SoilWaterLab/StreamGauge/Images/image029.jpg

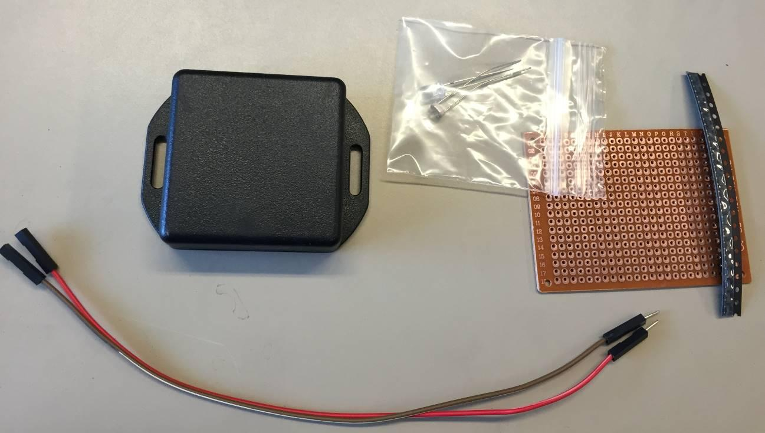
Images/image029.jpg
