SoilWaterLab/StreamGauge/Images/image031.jpg

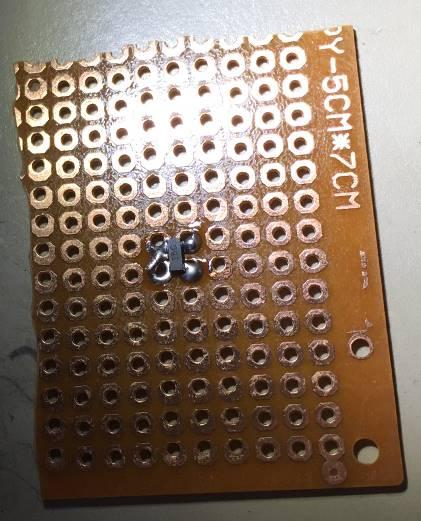
Images/image031.jpg
