SoilWaterLab/StreamGauge/Images/image033.jpg

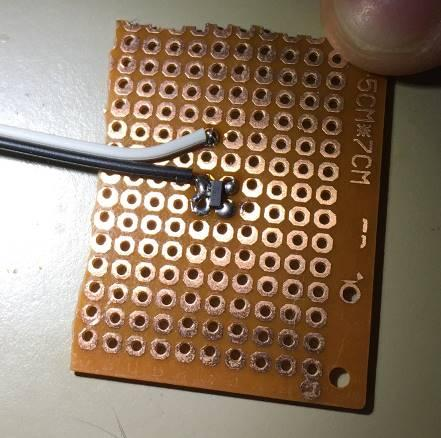
Images/image033.jpg
