SoilWaterLab/StreamGauge/Images/image035.jpg

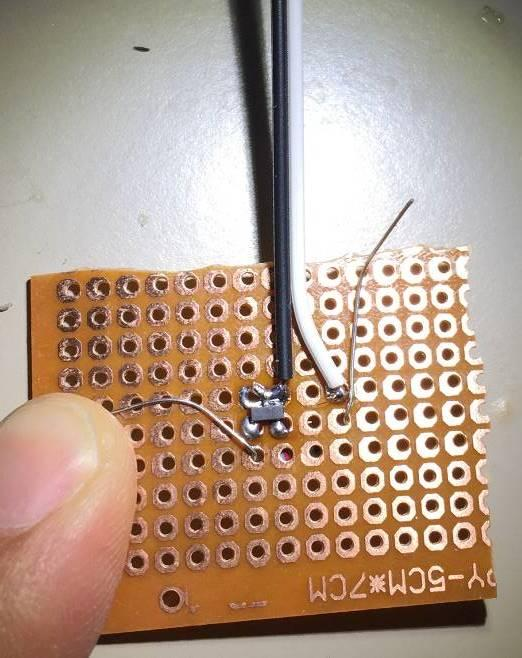
Images/image035.jpg
