SoilWaterLab/StreamGauge/Images/image037.jpg

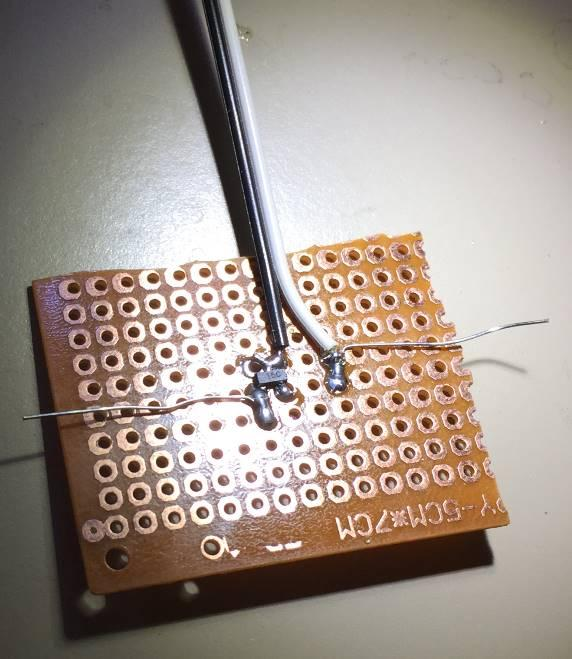
Images/image037.jpg
