SoilWaterLab/StreamGauge/Images/image039.jpg

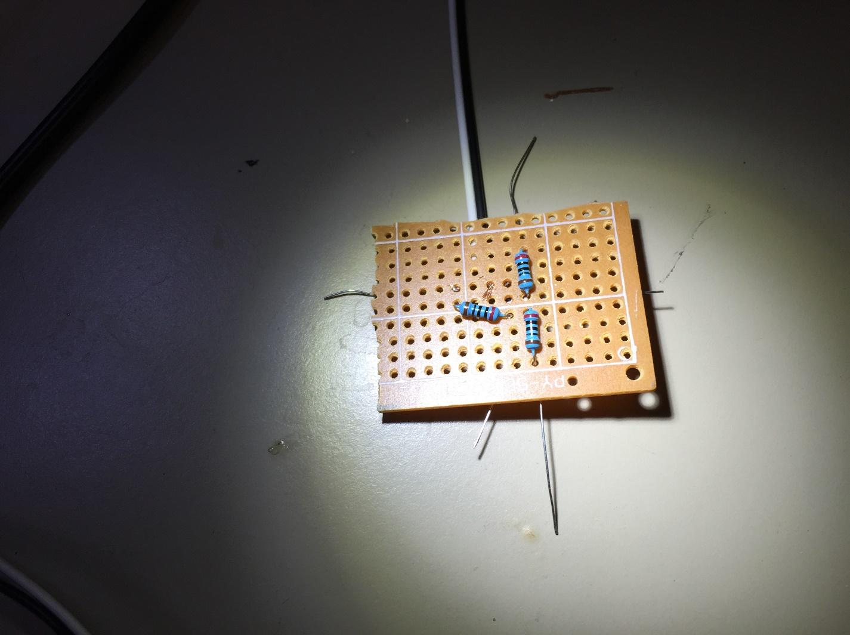
Images/image039.jpg
