SoilWaterLab/StreamGauge/Images/image041.jpg

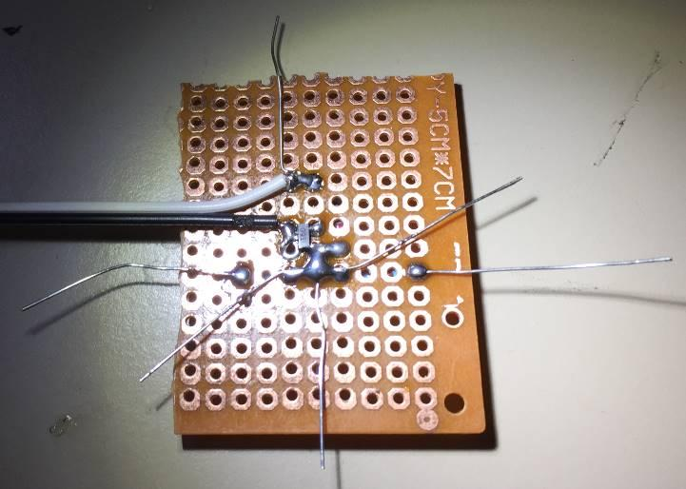
Images/image041.jpg
