SoilWaterLab/StreamGauge/Images/image043.jpg

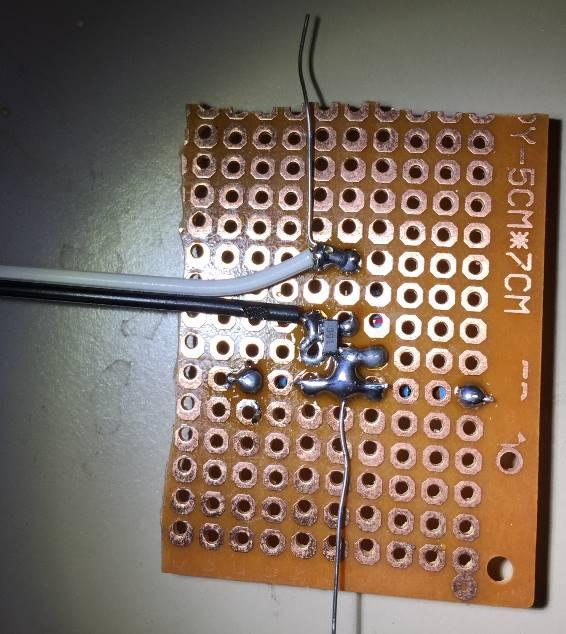
Images/image043.jpg
