SoilWaterLab/StreamGauge/Images/image045.jpg

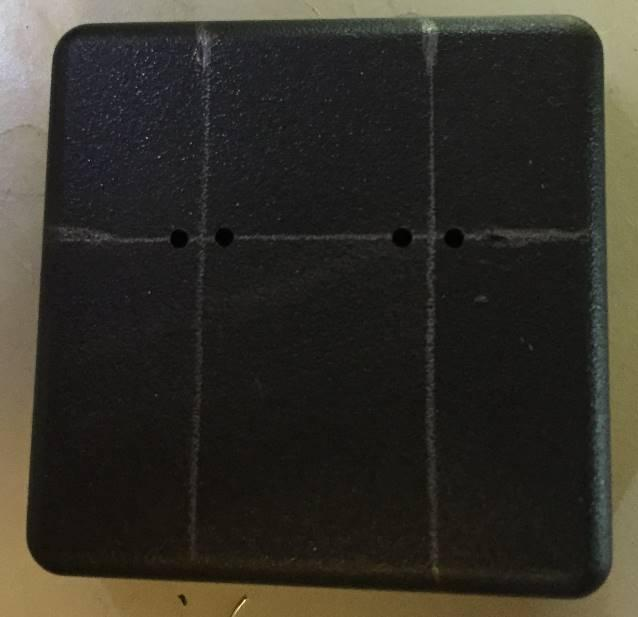
Images/image045.jpg
