SoilWaterLab/StreamGauge/Images/image047.jpg

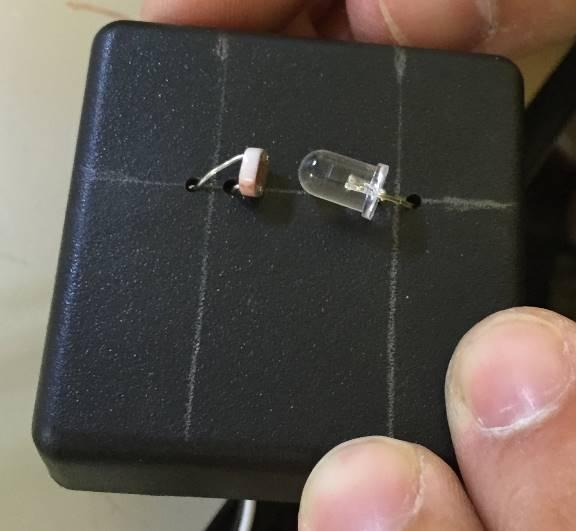
Images/image047.jpg
