SoilWaterLab/StreamGauge/Images/image049.jpg

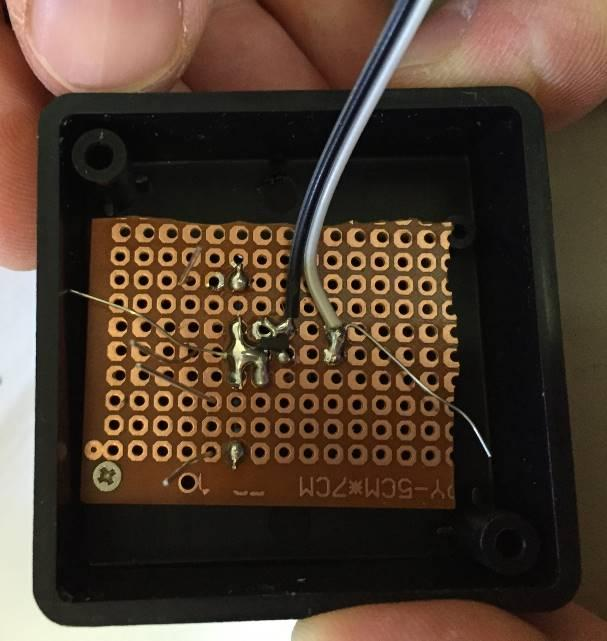
Images/image049.jpg
