SoilWaterLab/StreamGauge/Images/image051.jpg

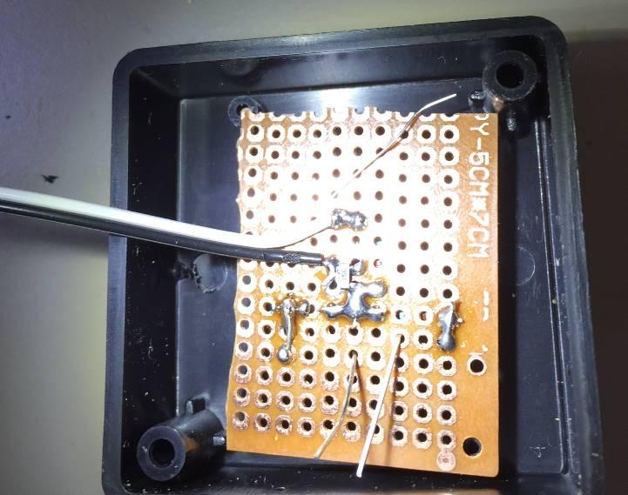
Images/image051.jpg
