SoilWaterLab/StreamGauge/Images/image053.jpg

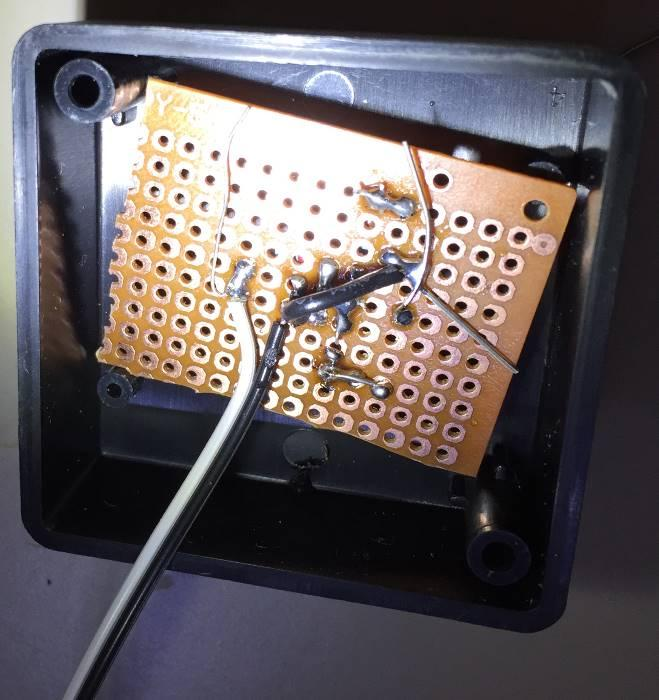
Images/image053.jpg
