SoilWaterLab/StreamGauge/Images/image055.jpg

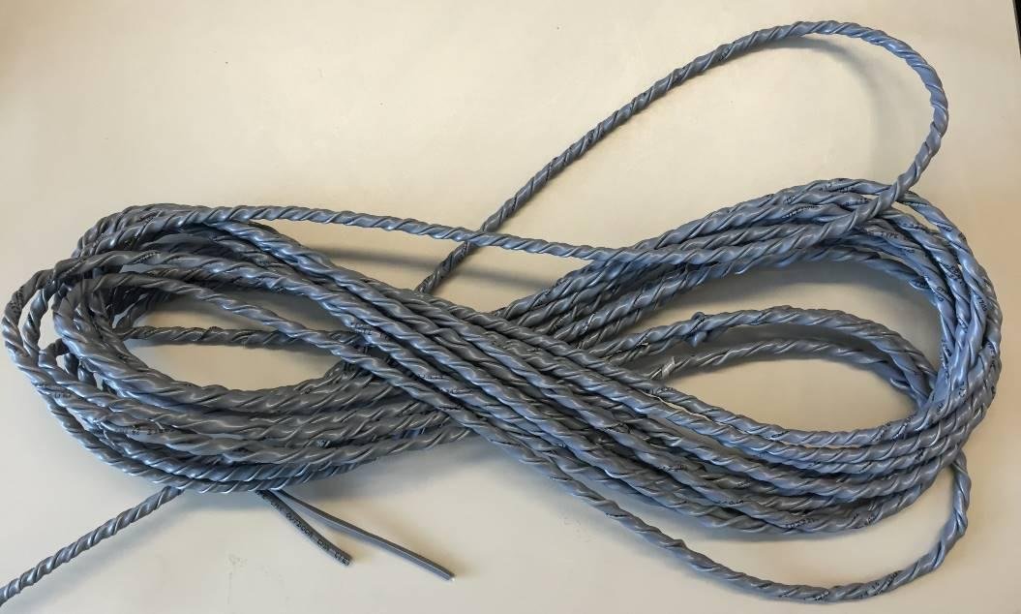
Images/image055.jpg
