SoilWaterLab/StreamGauge/Images/image057.jpg

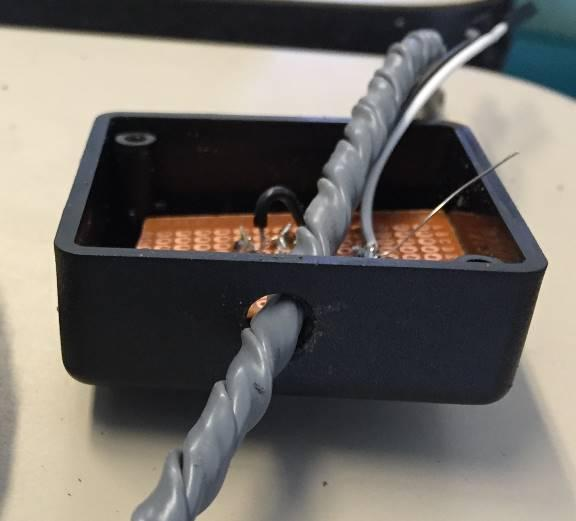
Images/image057.jpg
