SoilWaterLab/StreamGauge/Images/image059.jpg

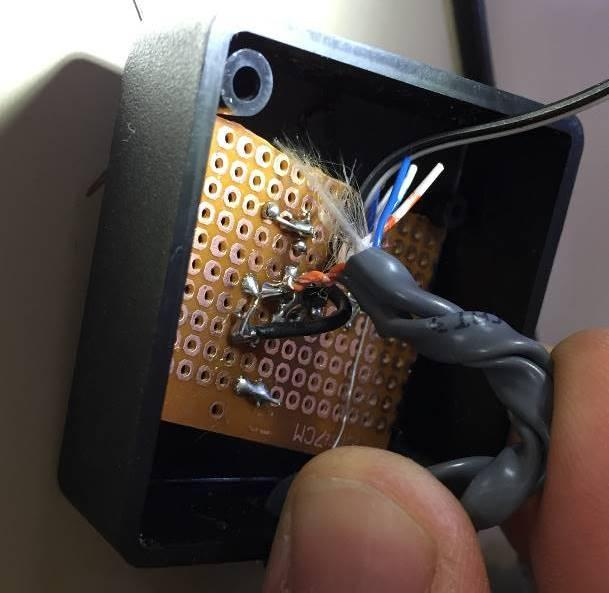
Images/image059.jpg
