SoilWaterLab/StreamGauge/Images/image061.jpg

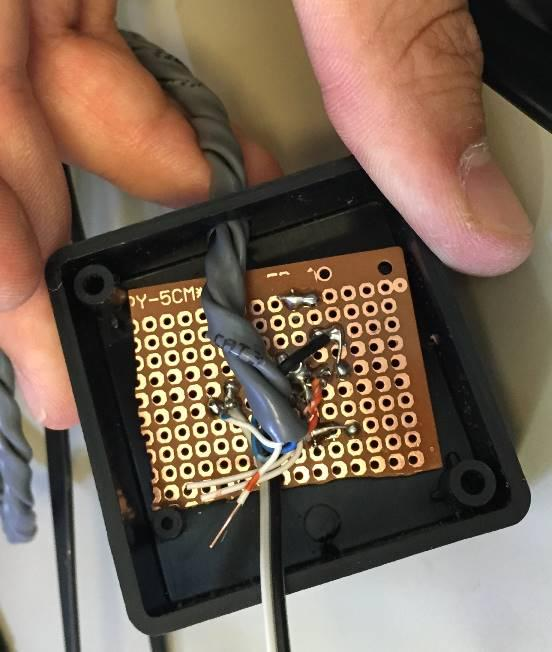
Images/image061.jpg
