SoilWaterLab/StreamGauge/Images/image063.jpg

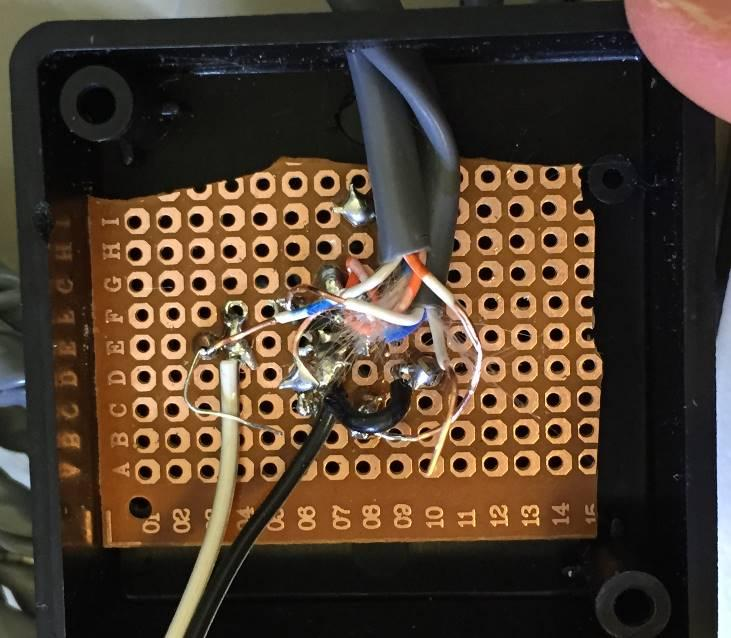
Images/image063.jpg
