SoilWaterLab/StreamGauge/Images/image065.jpg

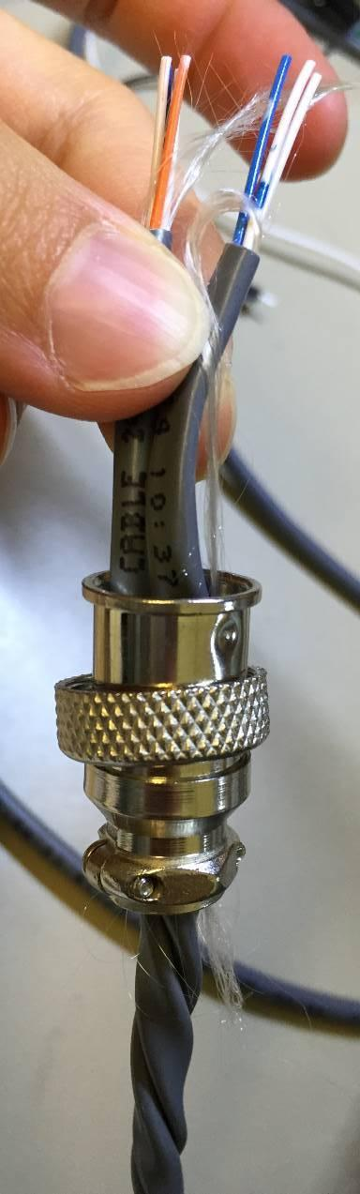
Images/image065.jpg
