SoilWaterLab/StreamGauge/Images/image067.jpg

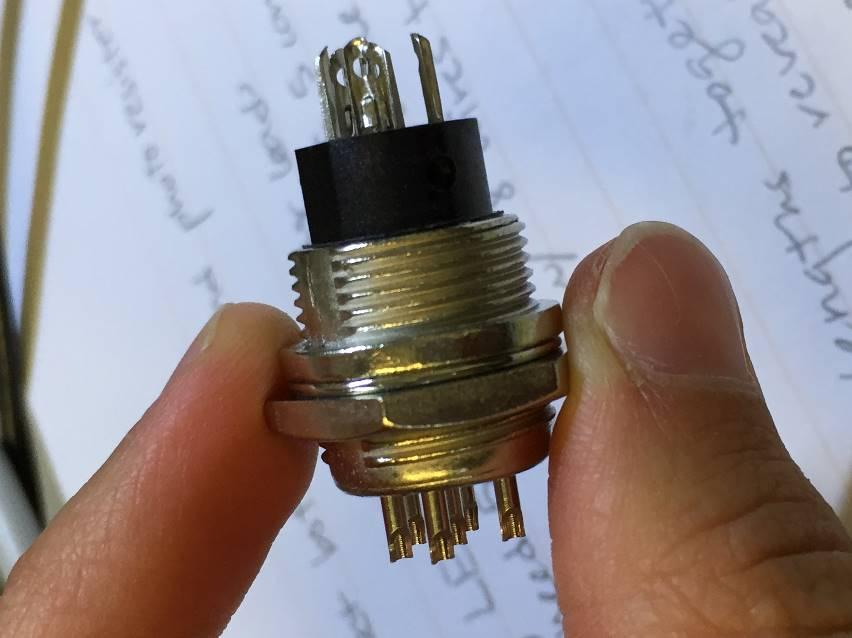
Images/image067.jpg
