SoilWaterLab/StreamGauge/Images/image069.jpg

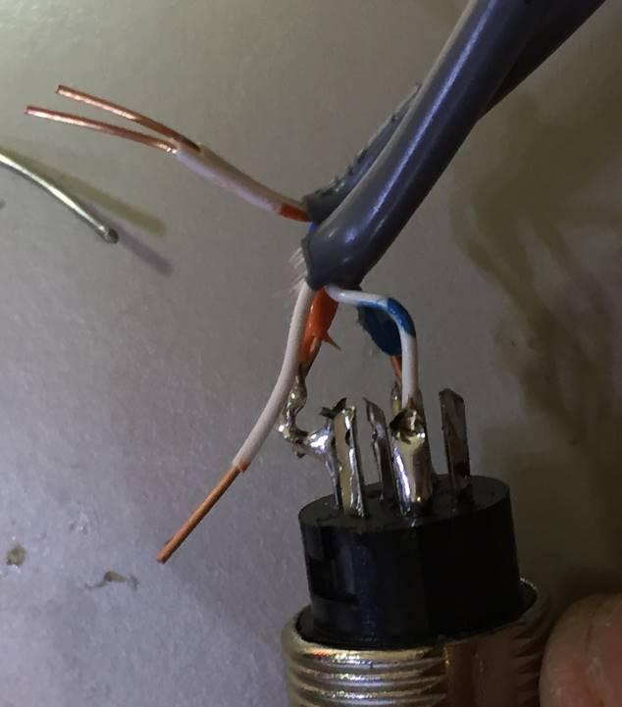
Images/image069.jpg
