SoilWaterLab/StreamGauge/Images/image071.jpg

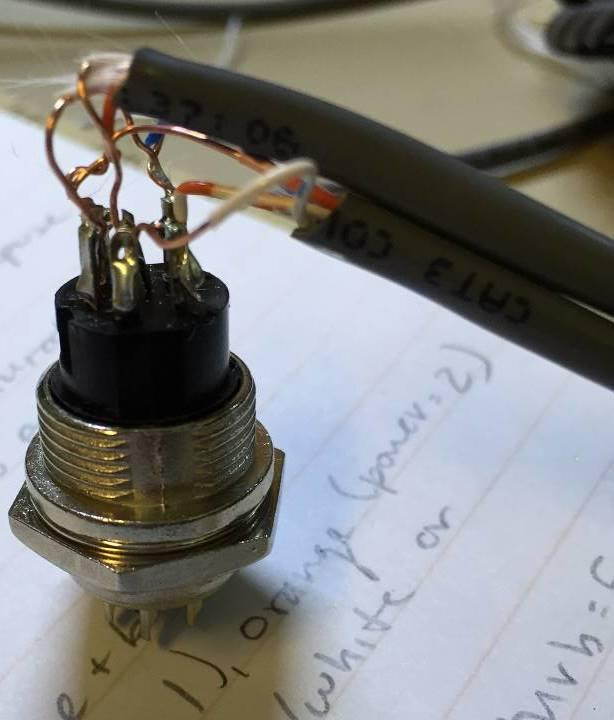
Images/image071.jpg
