SoilWaterLab/StreamGauge/Images/image073.jpg

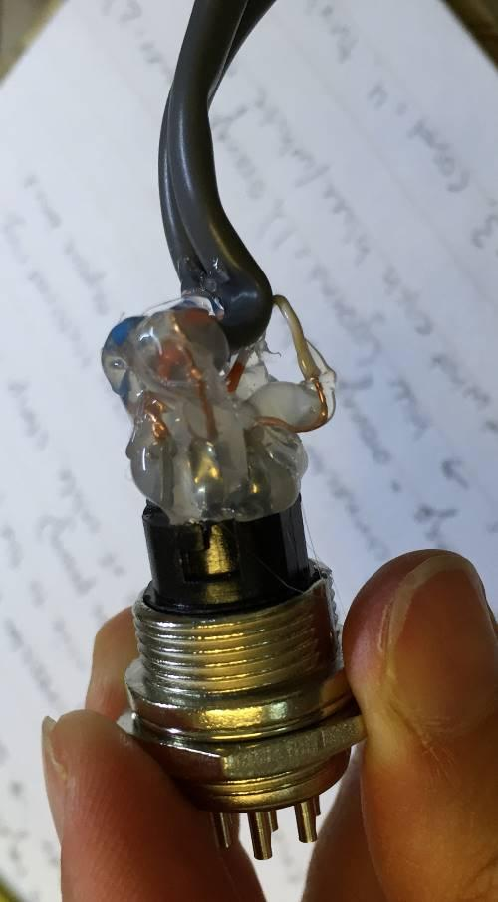
Images/image073.jpg
