SoilWaterLab/StreamGauge/Images/image075.jpg

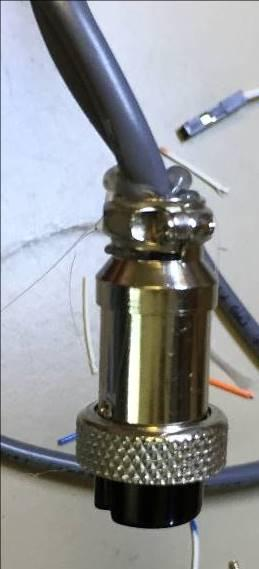
Images/image075.jpg
