SoilWaterLab/StreamGauge/Images/image077.jpg

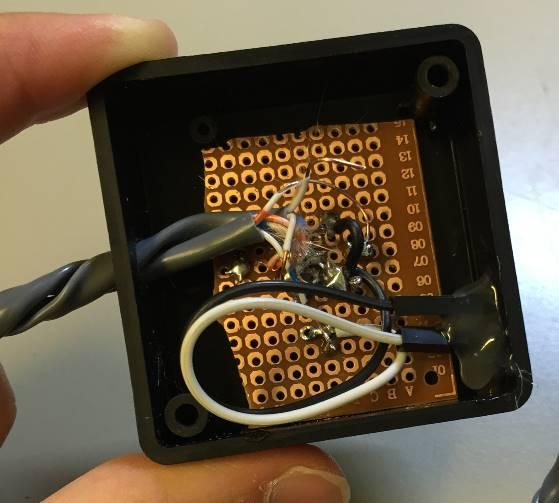
Images/image077.jpg
