SoilWaterLab/StreamGauge/Images/image079.jpg

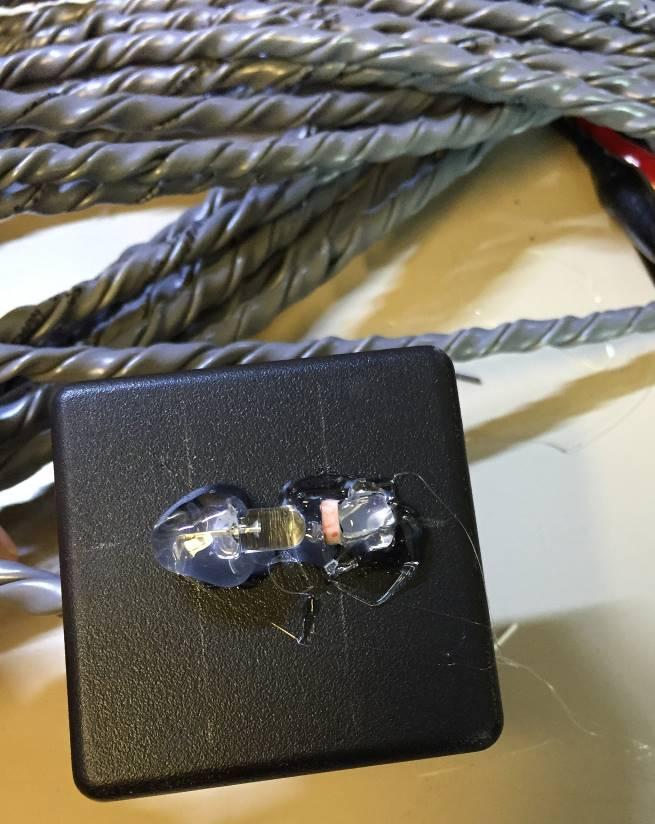
Images/image079.jpg
