SoilWaterLab/StreamGauge/Images/image081.jpg

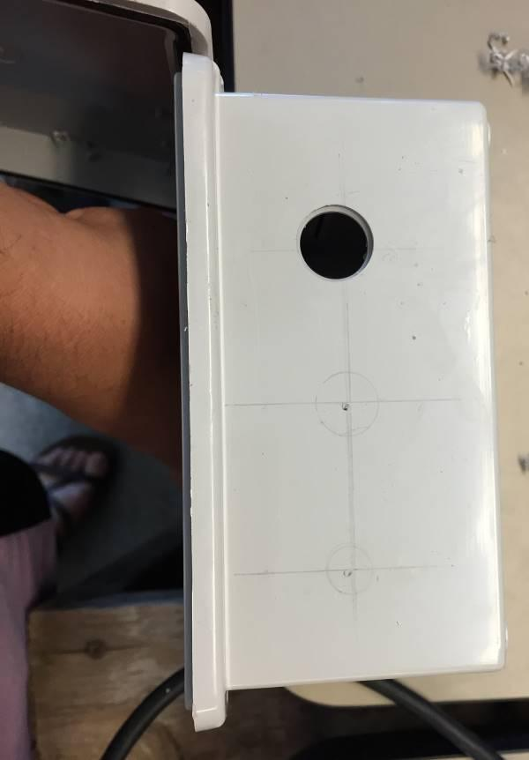
Images/image081.jpg
