SoilWaterLab/StreamGauge/Images/image083.jpg

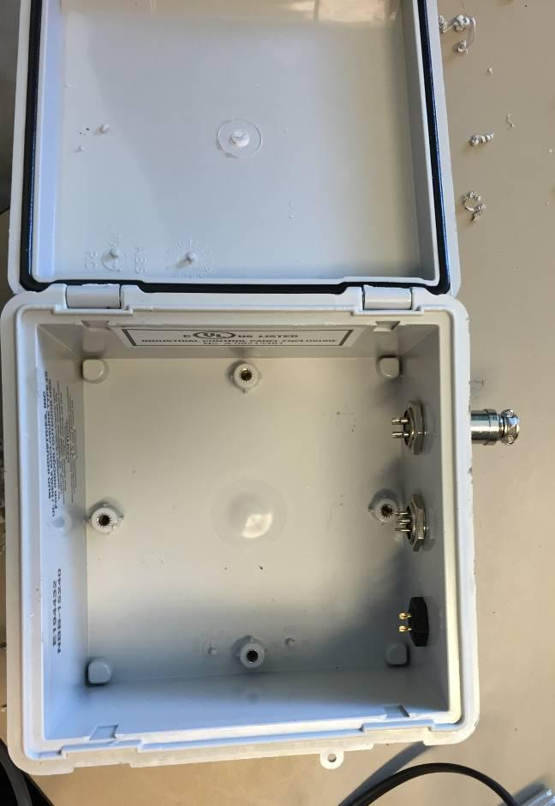
Images/image083.jpg
