SoilWaterLab/StreamGauge/Images/image085.jpg

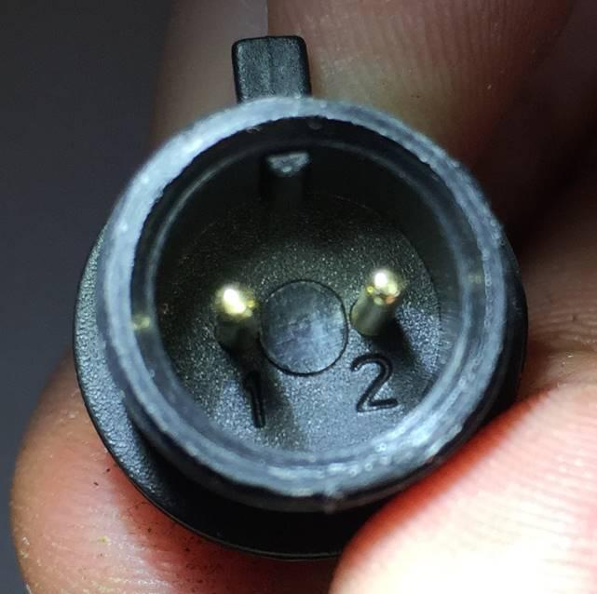
Images/image085.jpg
