SoilWaterLab/StreamGauge/Images/image087.jpg

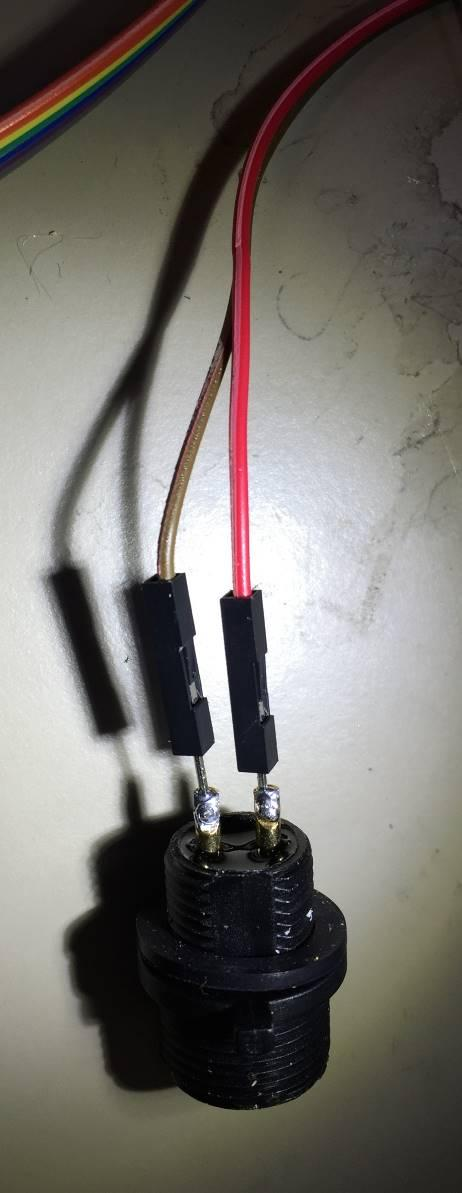
Images/image087.jpg
