SoilWaterLab/StreamGauge/Images/image089.jpg

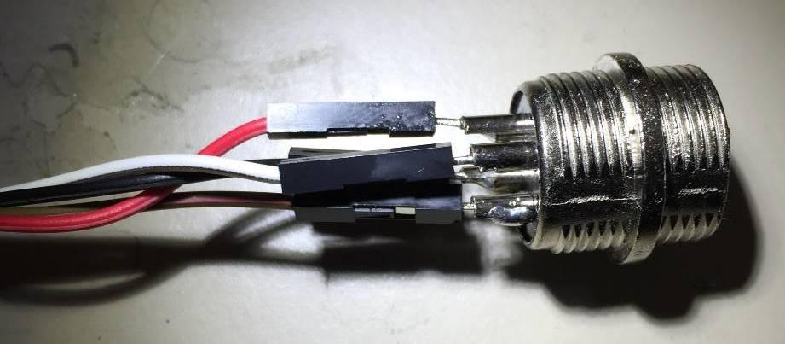
Images/image089.jpg
