SoilWaterLab/StreamGauge/Images/image091.jpg

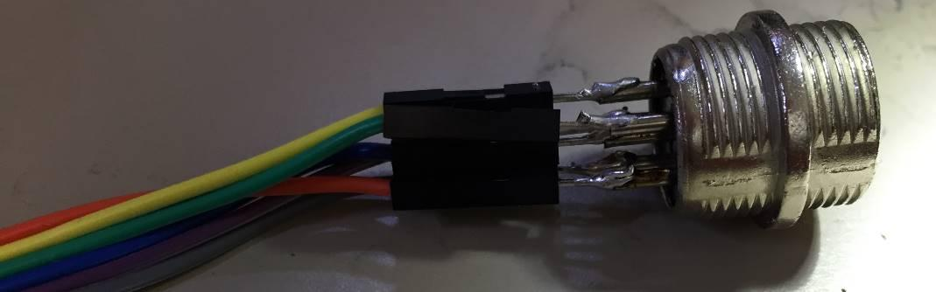
Images/image091.jpg
