SoilWaterLab/StreamGauge/Images/image093.jpg

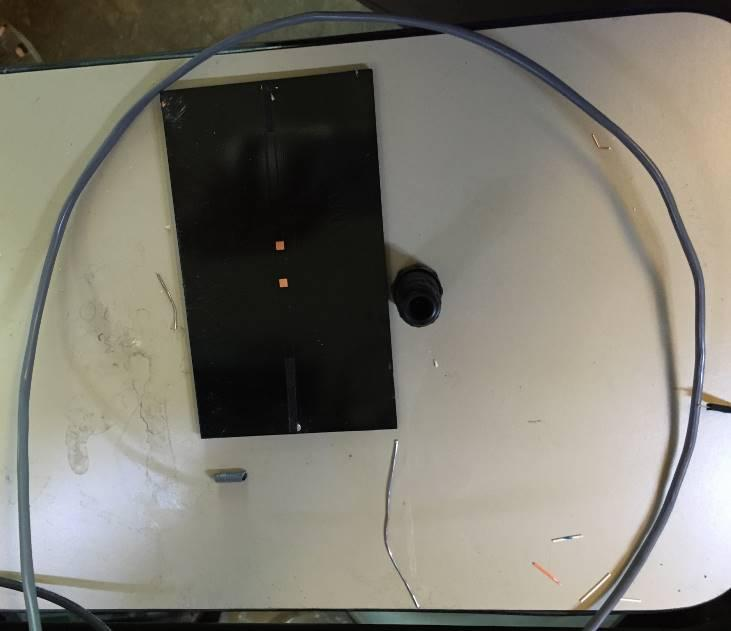
Images/image093.jpg
