SoilWaterLab/StreamGauge/Images/image095.jpg

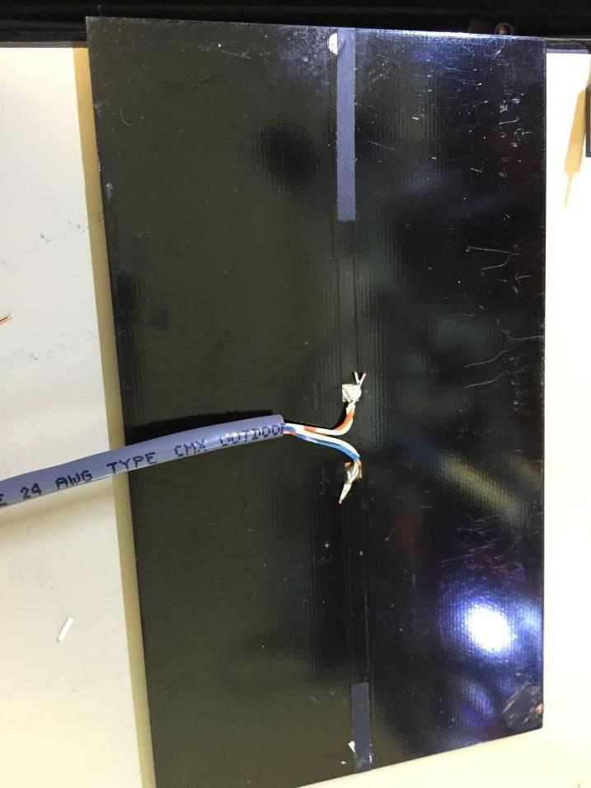
Images/image095.jpg
