SoilWaterLab/StreamGauge/Images/image097.jpg

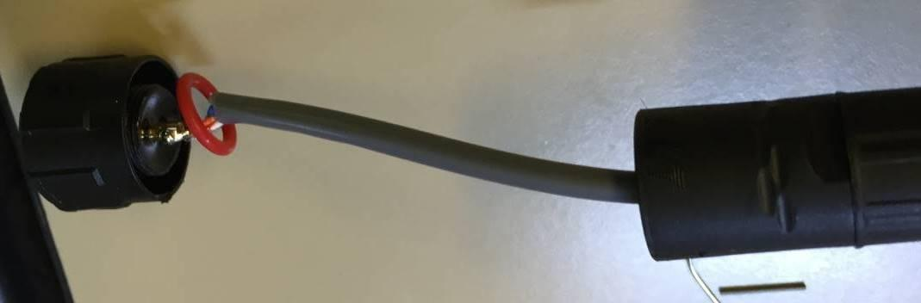
Images/image097.jpg
