SoilWaterLab/StreamGauge/Images/image099.jpg

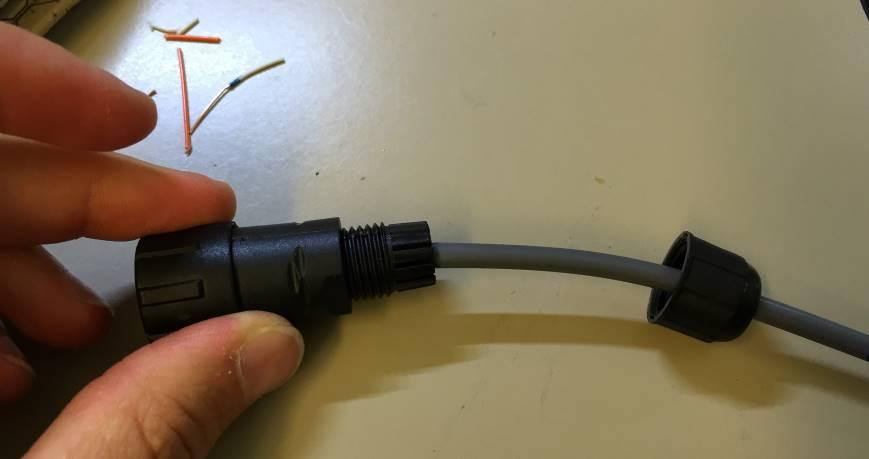
Images/image099.jpg
