SoilWaterLab/StreamGauge/Images/image101.jpg

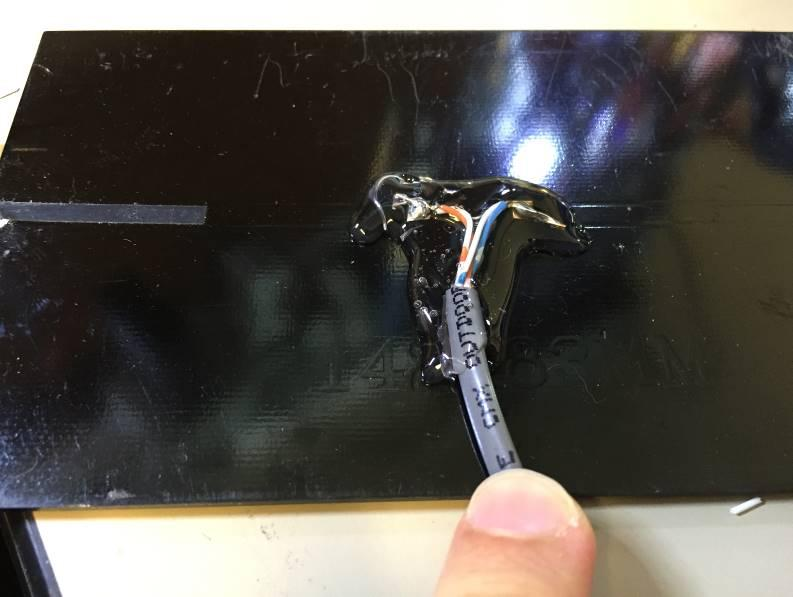
Images/image101.jpg
