SoilWaterLab/StreamGauge/Images/image103.jpg

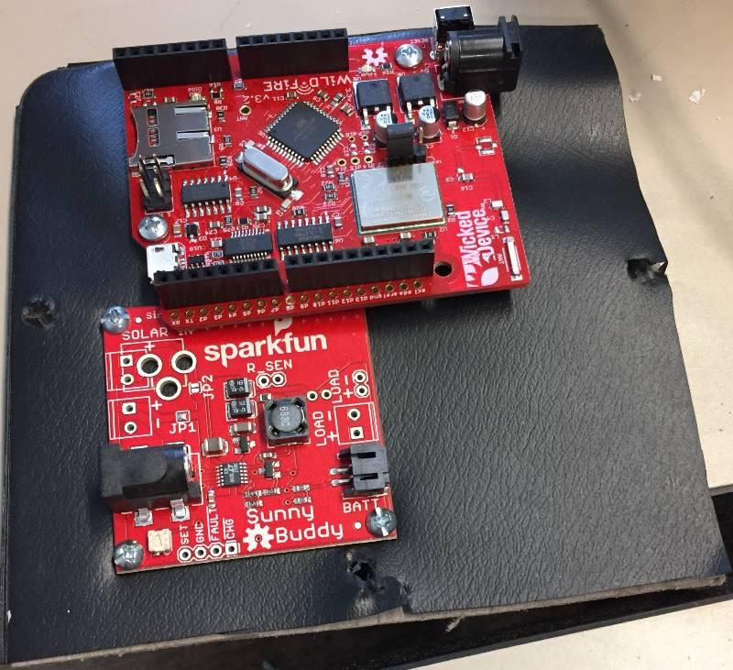
Images/image103.jpg
