SoilWaterLab/StreamGauge/Images/image105.jpg

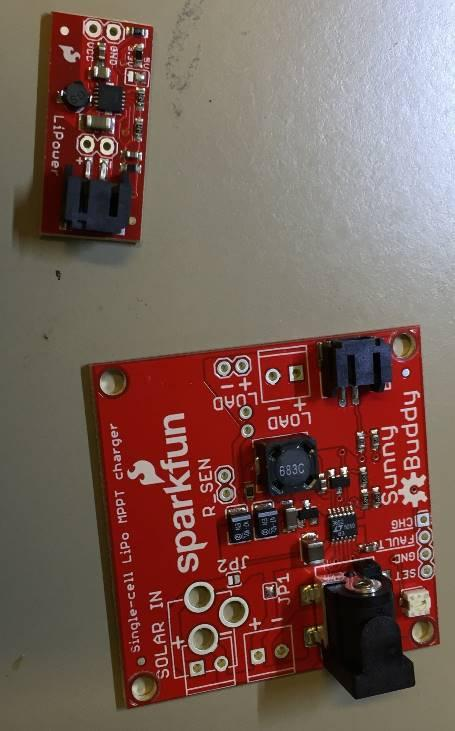
Images/image105.jpg
