SoilWaterLab/StreamGauge/Images/image107.jpg

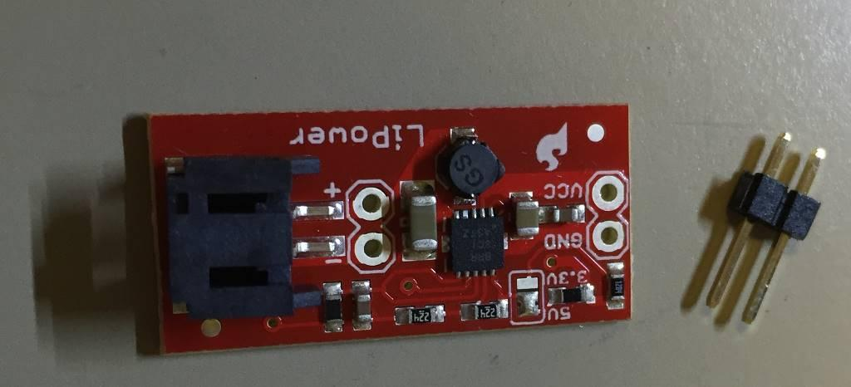
Images/image107.jpg
