SoilWaterLab/StreamGauge/Images/image109.jpg

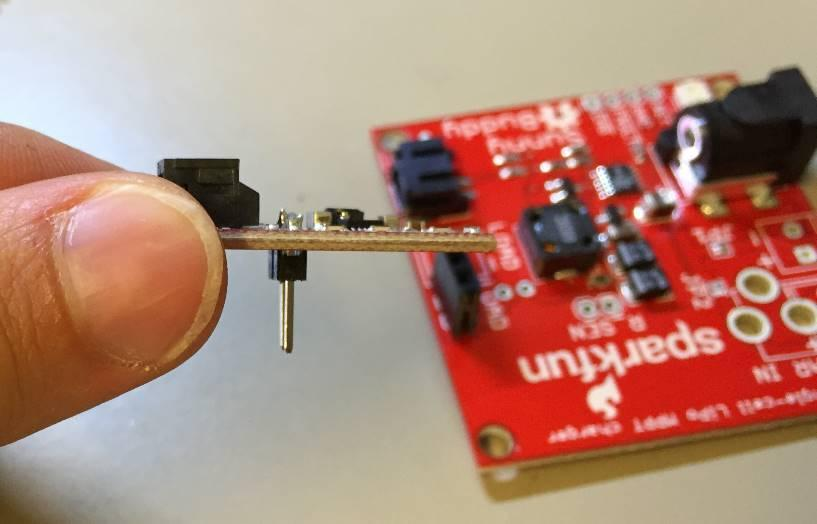
Images/image109.jpg
