SoilWaterLab/StreamGauge/Images/image111.jpg

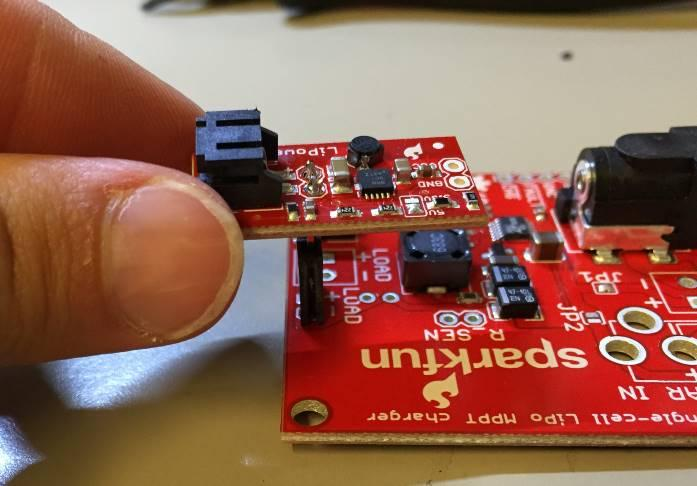
Images/image111.jpg
