SoilWaterLab/StreamGauge/Images/image113.jpg

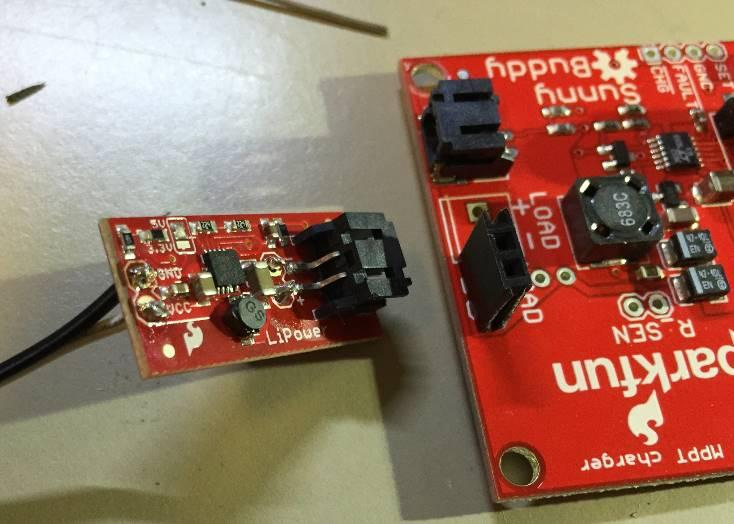
Images/image113.jpg
