SoilWaterLab/StreamGauge/Images/image115.jpg

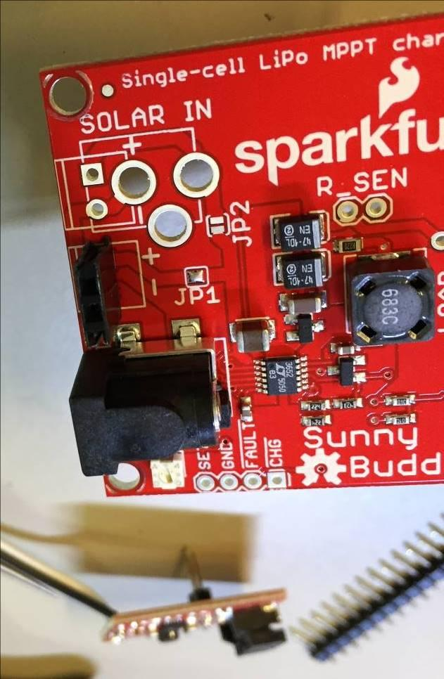
Images/image115.jpg
