SoilWaterLab/StreamGauge/Images/image117.jpg

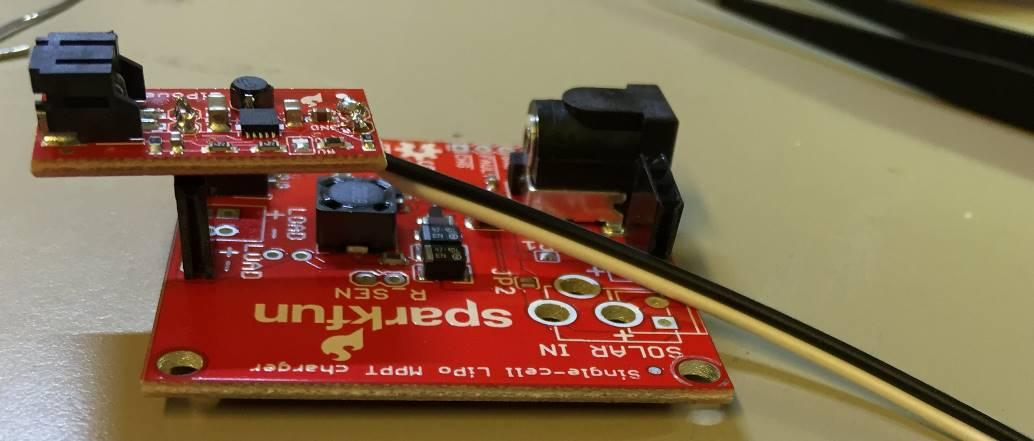
Images/image117.jpg
