SoilWaterLab/StreamGauge/Images/image119.jpg

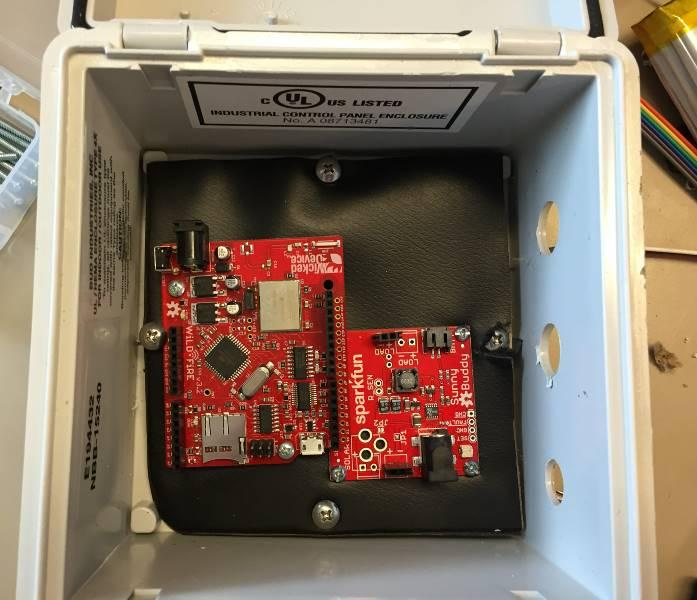
Images/image119.jpg
