SoilWaterLab/StreamGauge/Images/image121.jpg

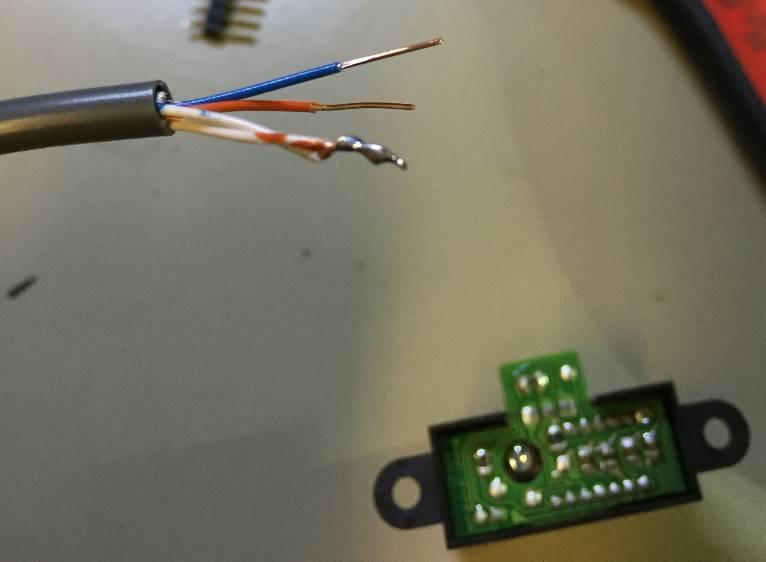
Images/image121.jpg
