SoilWaterLab/StreamGauge/Images/image123.jpg

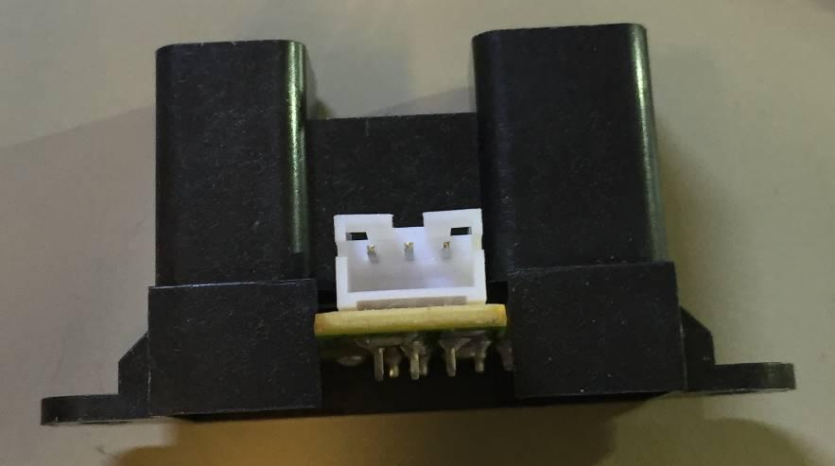
Images/image123.jpg
