SoilWaterLab/StreamGauge/Images/image125.jpg

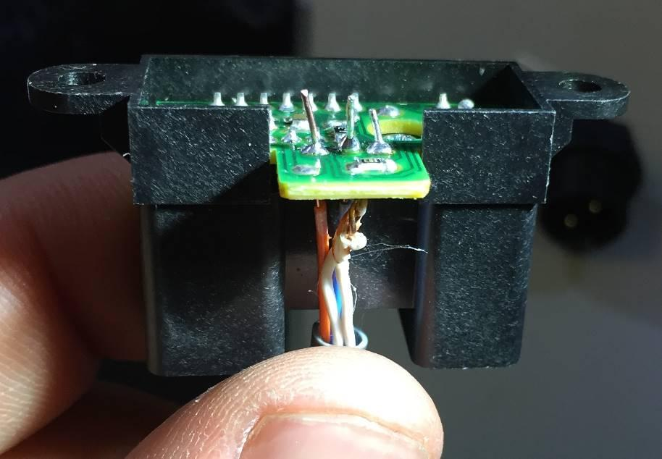
Images/image125.jpg
