SoilWaterLab/StreamGauge/Images/image127.jpg

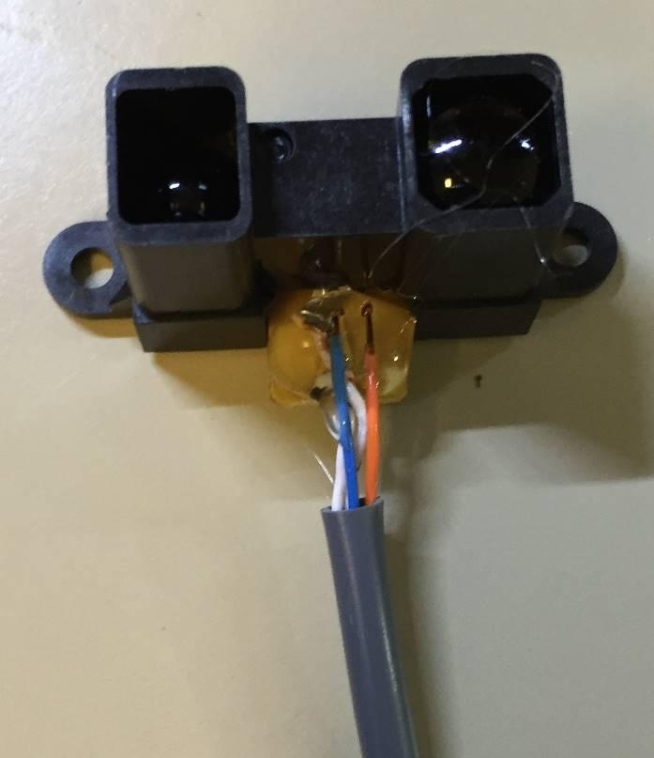
Images/image127.jpg
