SoilWaterLab/StreamGauge/Images/image129.jpg

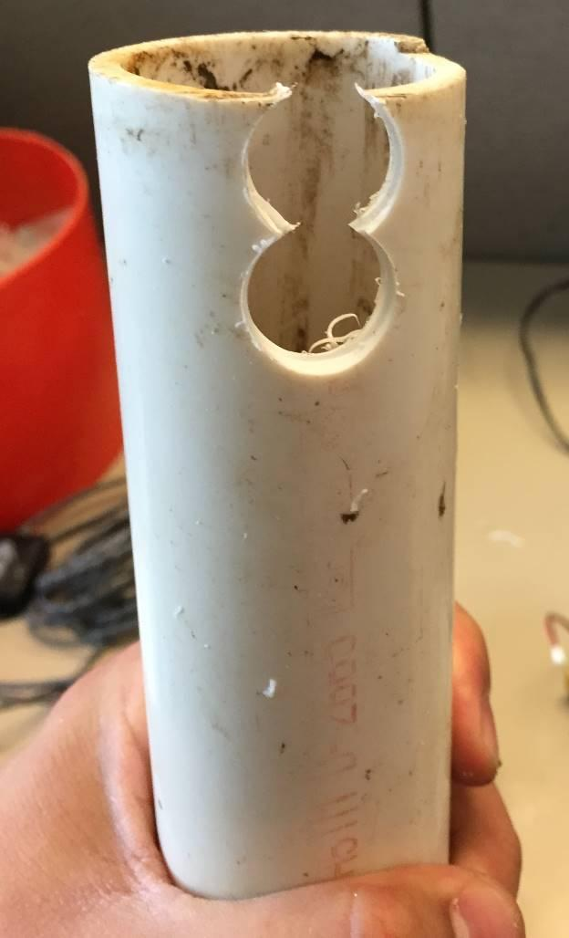
Images/image129.jpg
