SoilWaterLab/StreamGauge/Images/image131.jpg

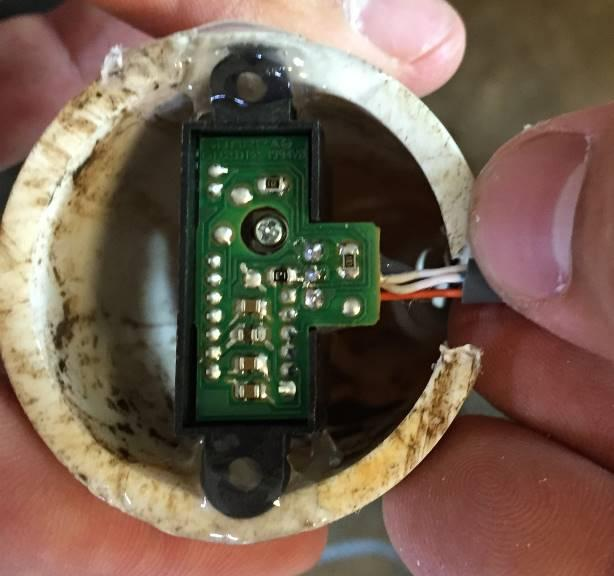
Images/image131.jpg
