SoilWaterLab/StreamGauge/Images/image133.jpg

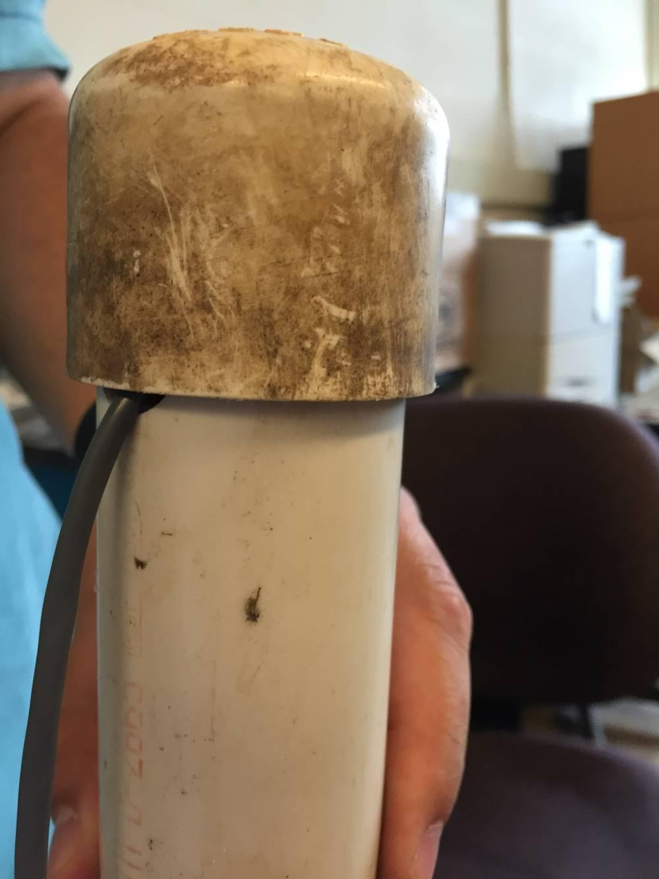
Images/image133.jpg
