SoilWaterLab/StreamGauge/Images/image135.jpg

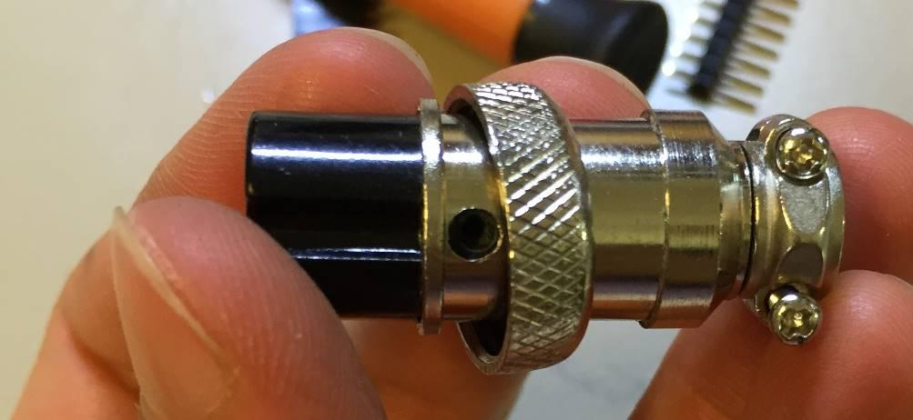
Images/image135.jpg
