SoilWaterLab/StreamGauge/Images/image137.jpg

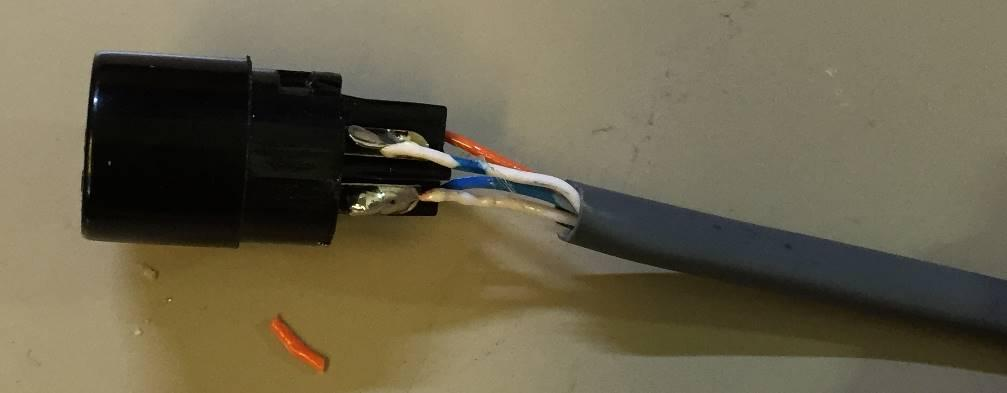
Images/image137.jpg
