SoilWaterLab/StreamGauge/Images/image139.jpg

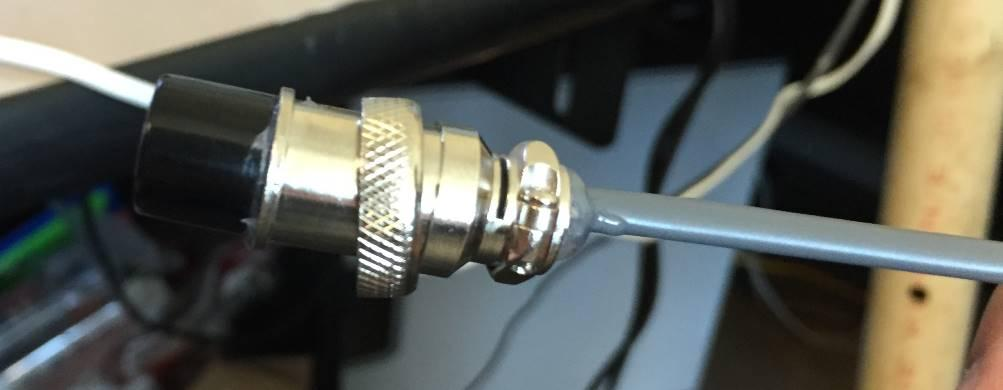
Images/image139.jpg
