SoilWaterLab/StreamGauge/Images/image141.jpg

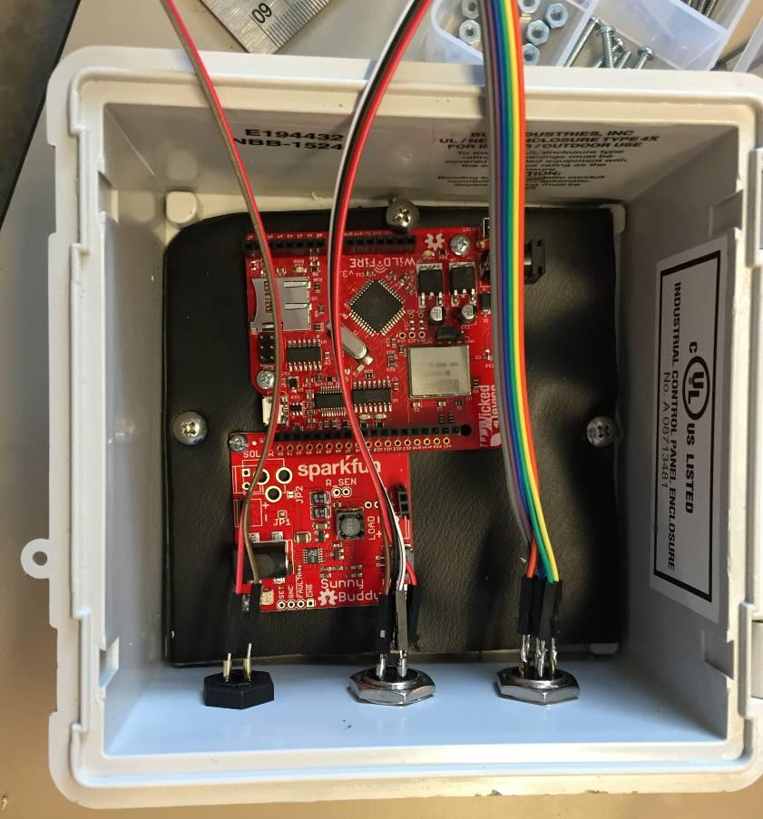
Images/image141.jpg
