SoilWaterLab/StreamGauge/Images/image143.jpg

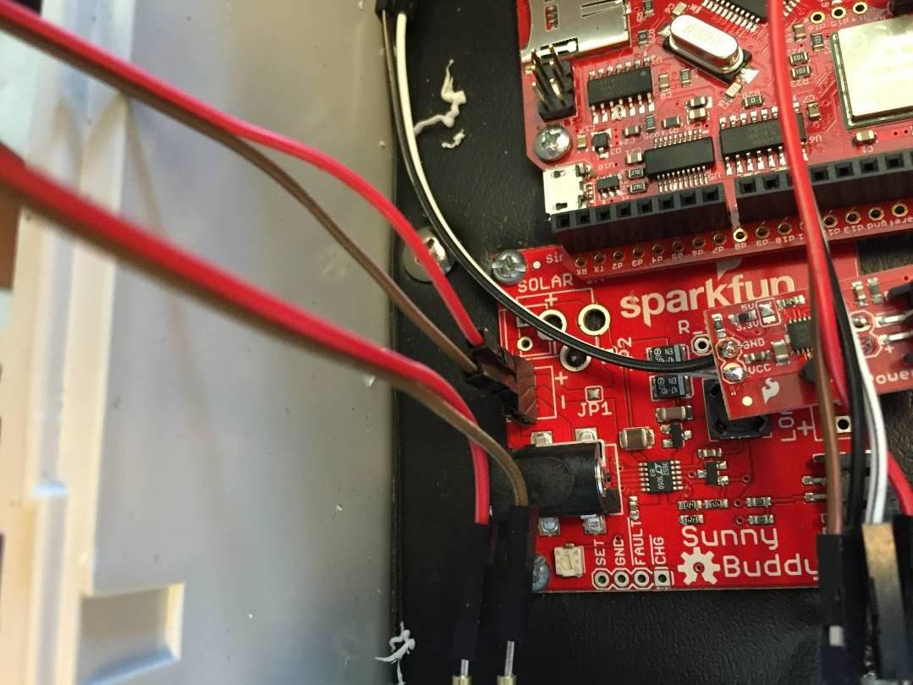
Images/image143.jpg
