SoilWaterLab/StreamGauge/Images/image145.jpg

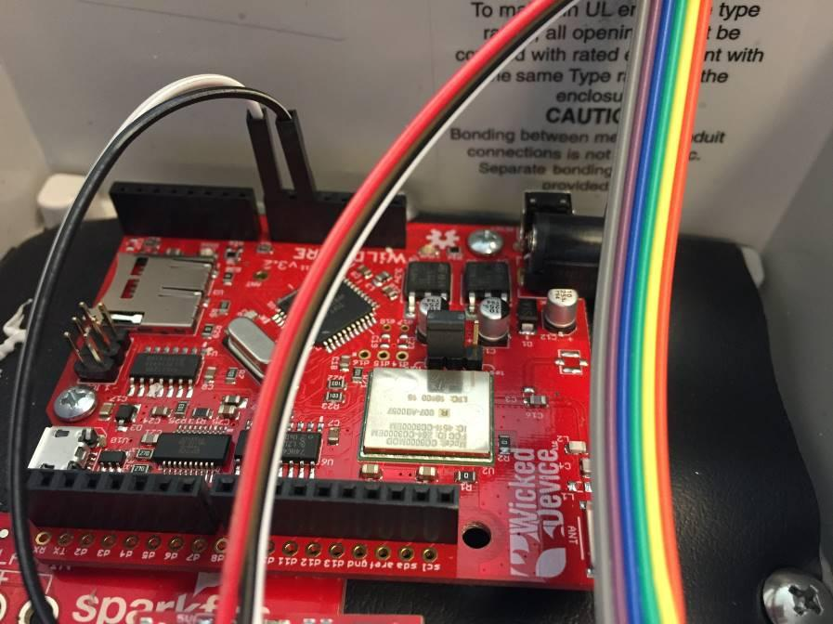
Images/image145.jpg
