SoilWaterLab/StreamGauge/Images/image147.jpg

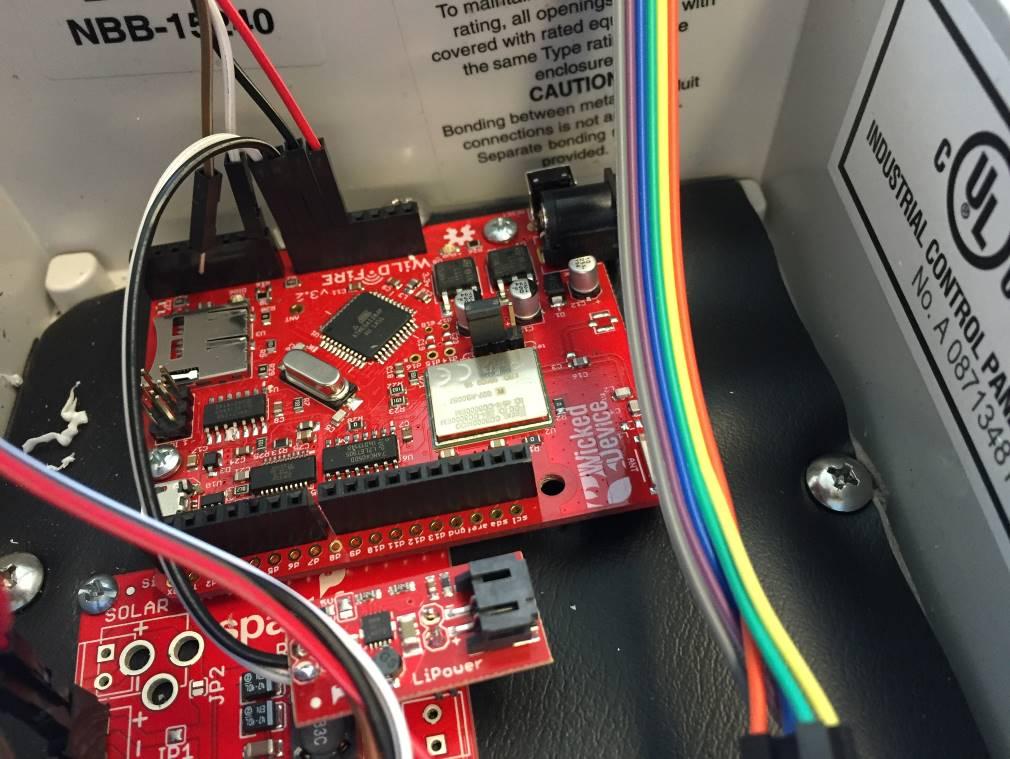
Images/image147.jpg
