SoilWaterLab/StreamGauge/Images/image149.jpg

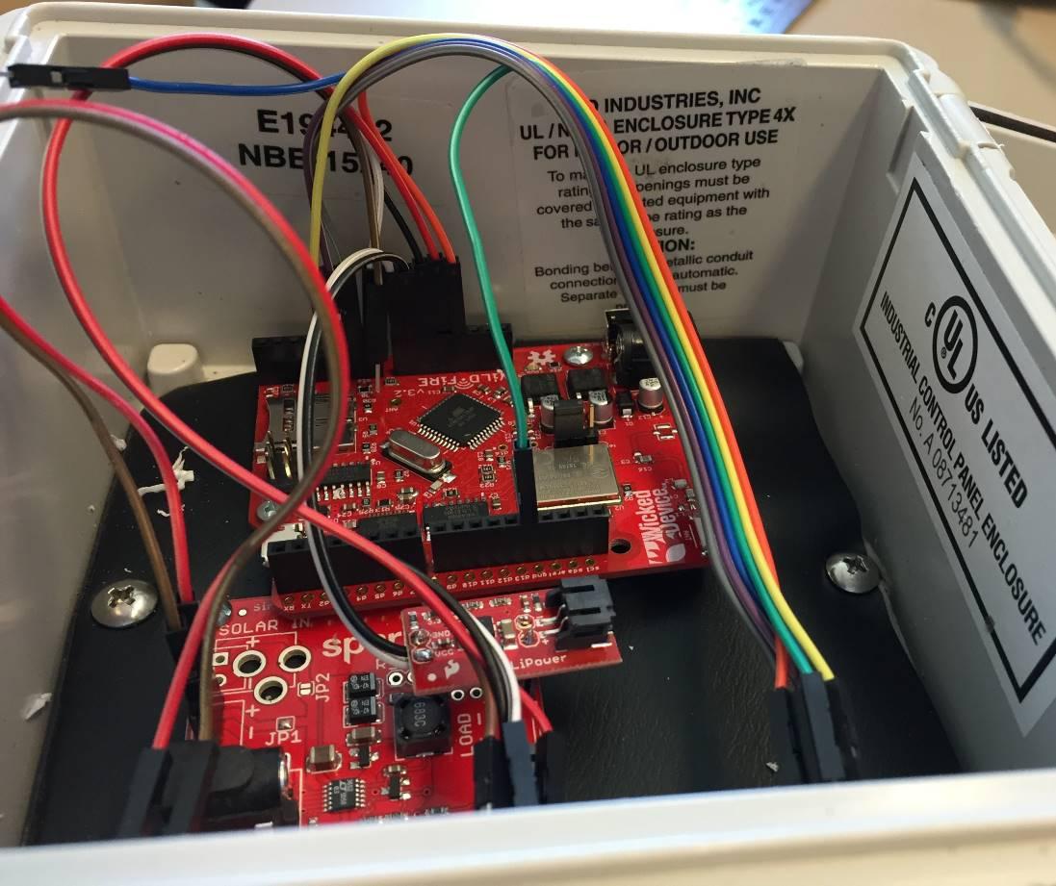
Images/image149.jpg
