SoilWaterLab/StreamGauge/Images/image151.jpg

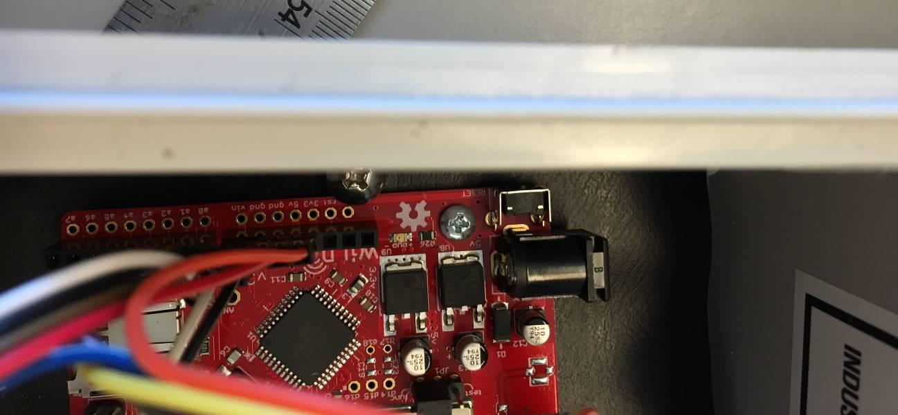
Images/image151.jpg
